matgaldino/Autonomous-Taxi/mechanical/encoder_mount/encoder_mount_front_view.png

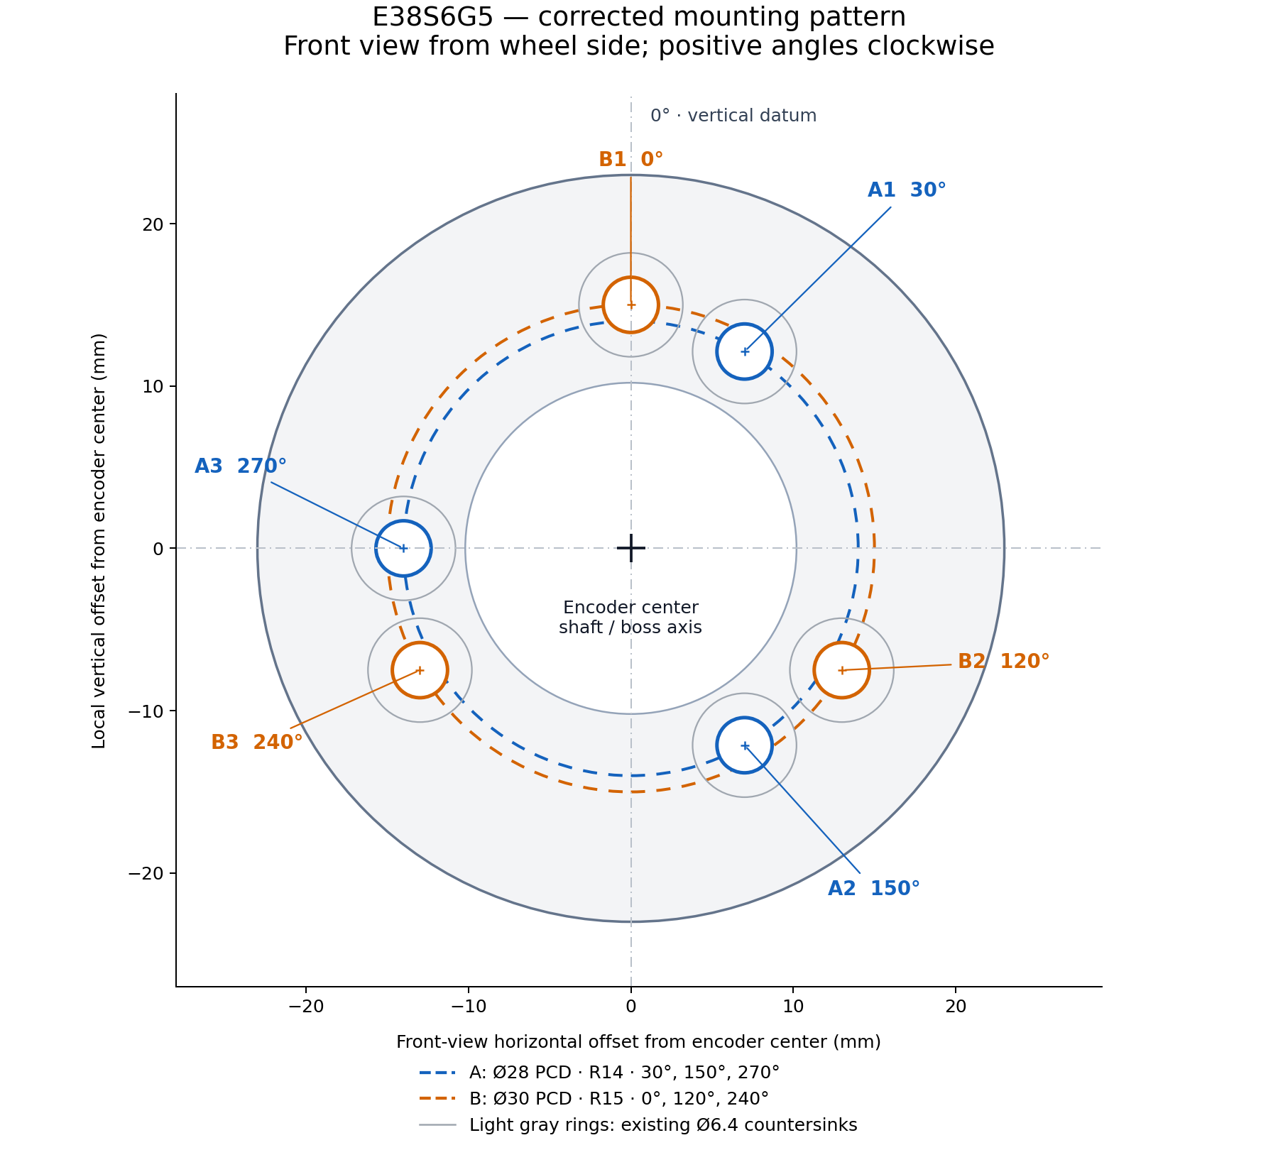
mechanical/encoder_mount/encoder_mount_front_view.png
