matgaldino/Autonomous-Taxi/mechanical/encoder_mount/vehicle_layout_front.png

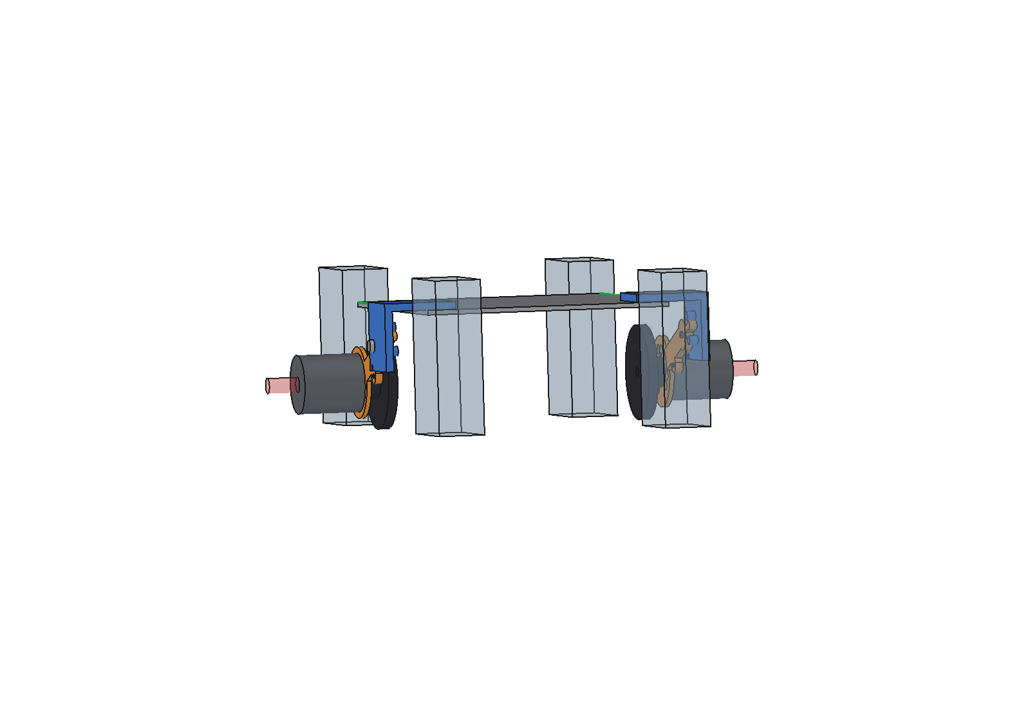
mechanical/encoder_mount/vehicle_layout_front.png
