matgaldino/Autonomous-Taxi/mechanical/encoder_mount/vehicle_layout_isometric.png

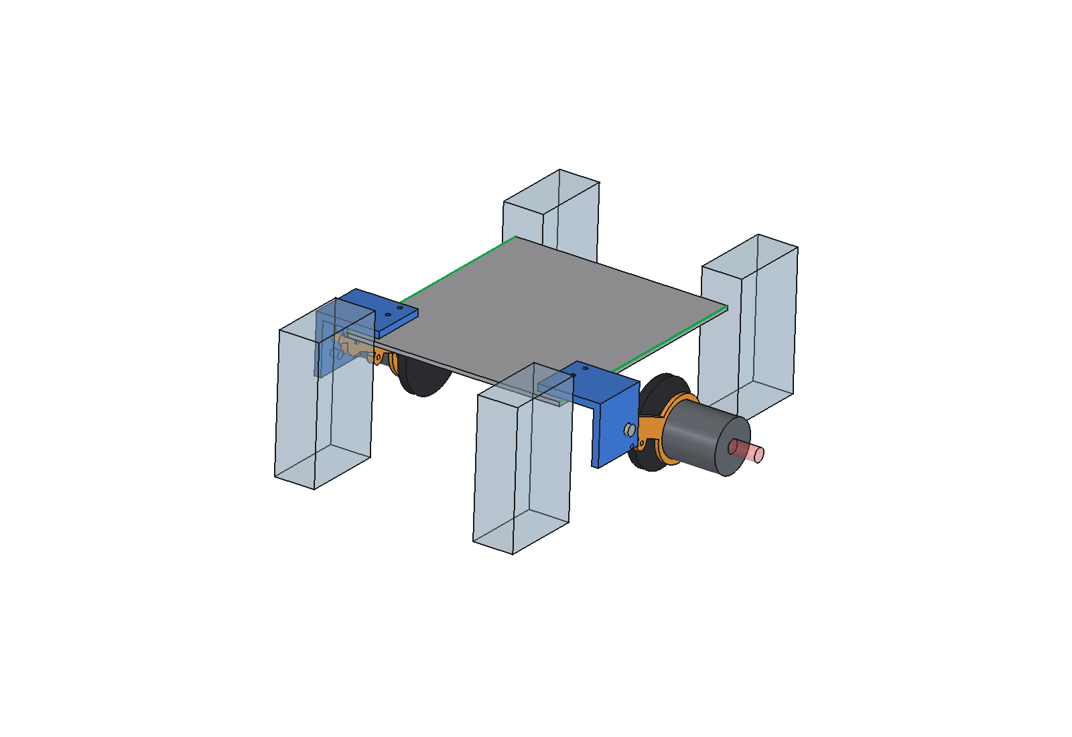
mechanical/encoder_mount/vehicle_layout_isometric.png
