matgaldino/Autonomous-Taxi/mechanical/encoder_mount/vehicle_layout_side.png

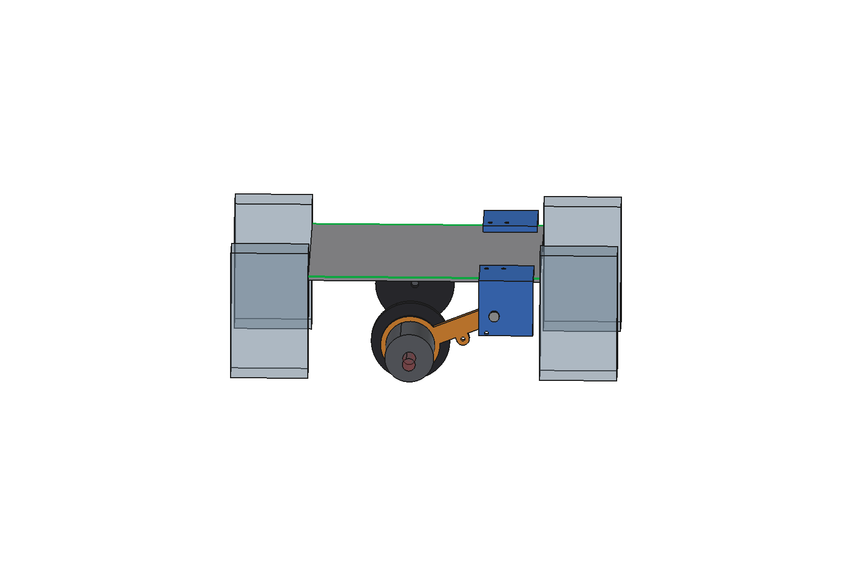
mechanical/encoder_mount/vehicle_layout_side.png
