matgaldino/Autonomous-Taxi/mechanical/encoder_mount/vehicle_layout_top.png

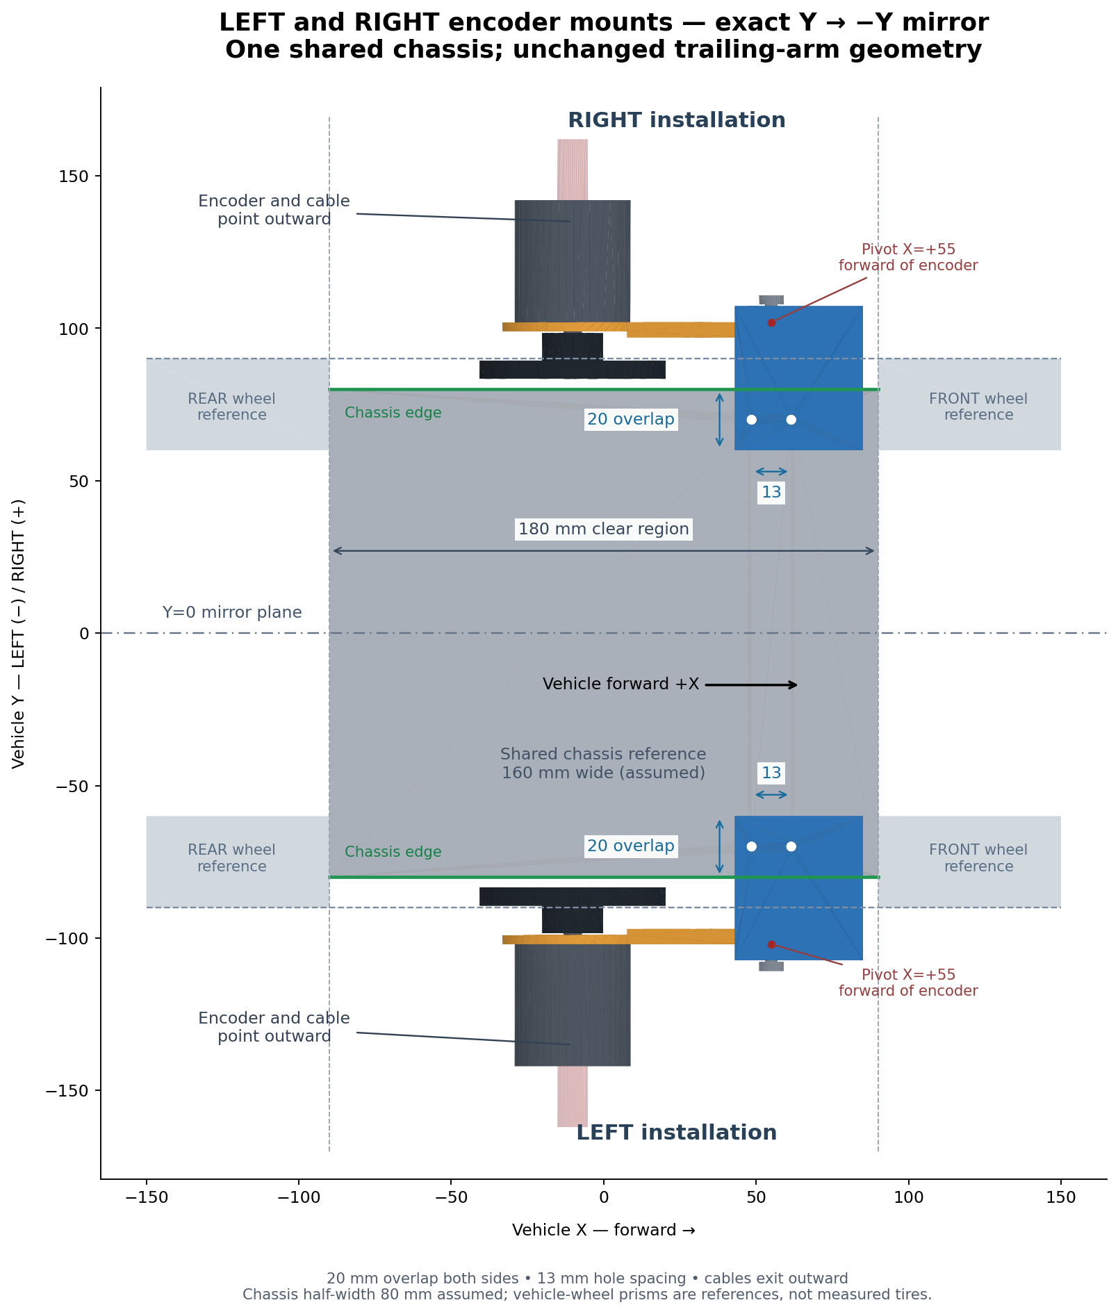
mechanical/encoder_mount/vehicle_layout_top.png
