matgaldino/Autonomous-Taxi/mechanical/encoder_mount/encoder_mount.FCStd

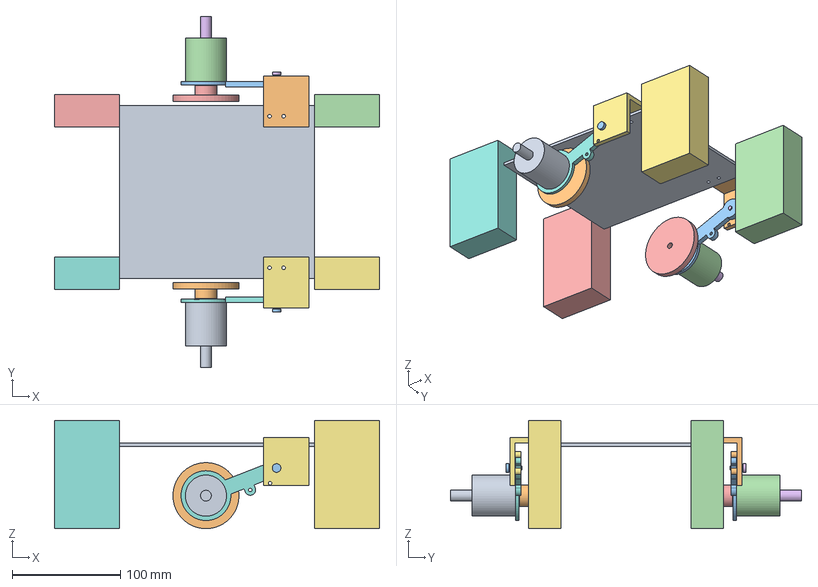
[picture p6: CAD file, 2026-11-02]
mechanical/encoder_mount/encoder_mount.FCStd
300.0 x 324.0 x 100.0 mm
ChassisReference
ChassisBracketRight
ArticulatedArmRight
EncoderRight
OdometryWheelRight
PivotPlaceholderRight
ChassisBracketLeft
ArticulatedArmLeft
EncoderLeft
OdometryWheelLeft
PivotPlaceholderLeft
FrontVehicleWheelReferenceRight
RearVehicleWheelReferenceRight
CableClearanceReferenceRight
FrontVehicleWheelReferenceLeft
RearVehicleWheelReferenceLeft
CableClearanceReferenceLeft
