matgaldino/Autonomous-Taxi/mechanical/encoder_mount/stl/articulated_arm_right.stl

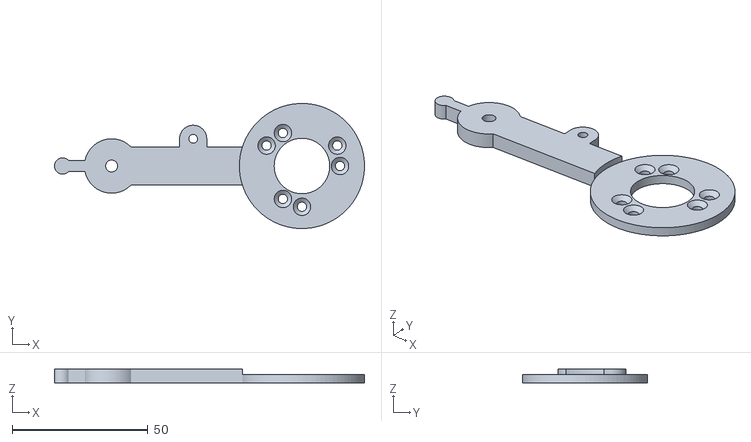
[picture p7: CAD file, 2026-11-02]
mechanical/encoder_mount/stl/articulated_arm_right.stl
114.0 x 46.0 x 5.00
