matgaldino/Autonomous-Taxi/mechanical/encoder_mount/stl/chassis_bracket_right.stl

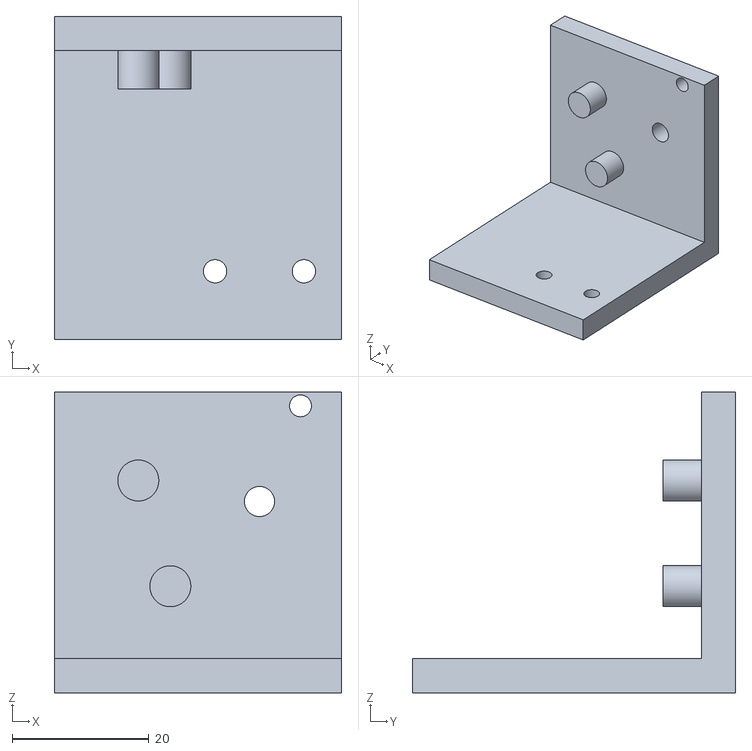
[picture p8: CAD file, 2026-11-02]
mechanical/encoder_mount/stl/chassis_bracket_right.stl
42.0 x 47.3 x 44.0
