matgaldino/Autonomous-Taxi/(list of files, cad)

Other CAD files:
mechanical/encoder_mount/stl/articulated_arm_left.stl
mechanical/encoder_mount/stl/chassis_bracket_left.stl
