matgaldino/Autonomous-Taxi/firmware/stm32_vehicle_controller/Core/Src/main.c

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
/* Includes ------------------------------------------------------------------*/
#include "main.h"

/* USER CODE BEGIN Includes */
#include <stdio.h>
#include <string.h>
/* USER CODE END Includes */

/* USER CODE BEGIN PM */
#define STEERING_NEG_US          1100
#define STEERING_CENTER_US       1400
#define STEERING_POS_US          1700

#define ESC_FULL_REVERSE_US      1100
#define ESC_REVERSE_START_US     1200
#define ESC_NEUTRAL_US           1500
#define ESC_FORWARD_START_US     1600
#define ESC_FULL_FORWARD_US      1900

#define COMMAND_MAX              1000
#define UART_BUFFER_SIZE         64
#define SERIAL_WATCHDOG_MS       500
/* USER CODE END PM */

TIM_HandleTypeDef htim1;

UART_HandleTypeDef huart2;

/* USER CODE BEGIN PV */
uint8_t rx_byte;

char rx_buffer[UART_BUFFER_SIZE];
uint8_t rx_index = 0;

uint32_t last_command_ms = 0;
uint8_t watchdog_active = 0;

int16_t steering_cmd = 0;
int16_t throttle_cmd = 0;

uint16_t steering_pwm = STEERING_CENTER_US;
uint16_t esc_pwm = ESC_NEUTRAL_US;

int8_t drive_direction = 0;
// -1 = reverse
//  0 = neutral
// +1 = forward
/* USER CODE END PV */

void SystemClock_Config(void);
static void MX_GPIO_Init(void);
static void MX_TIM1_Init(void);
static void MX_USART2_UART_Init(void);
/* USER CODE BEGIN 0 */
static int16_t clamp_command(int value)
{
    if (value > COMMAND_MAX)
        return COMMAND_MAX;

    if (value < -COMMAND_MAX)
        return -COMMAND_MAX;

    return (int16_t)value;
}


static uint16_t steering_to_pwm(int16_t command)
{
    if (command > 0)
    {
        return STEERING_CENTER_US -
            ((uint32_t)command *
            (STEERING_CENTER_US - STEERING_NEG_US)) /
            COMMAND_MAX;
    }

    if (command < 0)
    {
        return STEERING_CENTER_US +
            ((uint32_t)(-command) *
            (STEERING_POS_US - STEERING_CENTER_US)) /
            COMMAND_MAX;
    }

    return STEERING_CENTER_US;
}


static uint16_t throttle_to_pwm(int16_t command)
{
    if (command > 0)
    {
        return ESC_FORWARD_START_US +
            ((uint32_t)command *
            (ESC_FULL_FORWARD_US - ESC_FORWARD_START_US)) /
            COMMAND_MAX;
    }

    if (command < 0)
    {
        return ESC_REVERSE_START_US -
            ((uint32_t)(-command) *
            (ESC_REVERSE_START_US - ESC_FULL_REVERSE_US)) /
            COMMAND_MAX;
    }

    return ESC_NEUTRAL_US;
}


static void apply_vehicle_command(int16_t steering, int16_t throttle)
{
    steering = clamp_command(steering);
    throttle = clamp_command(throttle);

    steering_cmd = steering;
    throttle_cmd = throttle;

    steering_pwm = steering_to_pwm(steering);

    __HAL_TIM_SET_COMPARE(
        &htim1,
        TIM_CHANNEL_1,
        steering_pwm
    );

    int8_t requested_direction = 0;

    if (throttle > 0)
        requested_direction = 1;
    else if (throttle < 0)
        requested_direction = -1;

    /*
     * Direct direction change:
     *
     * forward -> reverse
     * reverse -> forward
     *
     * Force an explicit neutral cycle first.
     */
    if (
        drive_direction != 0 &&
        requested_direction != 0 &&
        requested_direction != drive_direction
    )
    {
        esc_pwm = ESC_NEUTRAL_US;
        drive_direction = 0;

        __HAL_TIM_SET_COMPARE(
            &htim1,
            TIM_CHANNEL_4,
            esc_pwm
        );

        return;
    }

    esc_pwm = throttle_to_pwm(throttle);

    __HAL_TIM_SET_COMPARE(
        &htim1,
        TIM_CHANNEL_4,
        esc_pwm
    );

    drive_direction = requested_direction;
}


static void send_status(void)
{
    char buffer[128];

    snprintf(
        buffer,
        sizeof(buffer),
        "OK S=%d T=%d SPWM=%u EPWM=%u\r\n",
        steering_cmd,
        throttle_cmd,
        steering_pwm,
        esc_pwm
    );

    HAL_UART_Transmit(
        &huart2,
        (uint8_t *)buffer,
        strlen(buffer),
        HAL_MAX_DELAY
    );
}


static void process_command(char *line)
{
    int steering;
    int throttle;

    if (sscanf(line, "C,%d,%d", &steering, &throttle) == 2)
    {
        apply_vehicle_command(
            (int16_t)steering,
            (int16_t)throttle
        );

        last_command_ms = HAL_GetTick();
        watchdog_active = 0;

        send_status();
    }
}
/* USER CODE END 0 */

/**
  * @brief  The application entry point.
  * @retval int
  */
int main(void)
{

  /* MCU Configuration--------------------------------------------------------*/

  /* Reset of all peripherals, Initializes the Flash interface and the Systick. */
  HAL_Init();

  /* Configure the system clock */
  SystemClock_Config();

  /* Initialize all configured peripherals */
  MX_GPIO_Init();
  MX_TIM1_Init();
  MX_USART2_UART_Init();
  /* USER CODE BEGIN 2 */
  HAL_TIM_PWM_Start(&htim1, TIM_CHANNEL_1);
  HAL_TIM_PWM_Start(&htim1, TIM_CHANNEL_4);

  apply_vehicle_command(0, 0);

  last_command_ms = HAL_GetTick();
  /* USER CODE END 2 */

  /* Initialize leds */
  BSP_LED_Init(LED_GREEN);

  /* Infinite loop */
  /* USER CODE BEGIN WHILE */
  while (1)
  {
	  if (HAL_UART_Receive(&huart2, &rx_byte, 1, 1) == HAL_OK)
	      {
	          if (rx_byte == '\n' || rx_byte == '\r')
	          {
	              if (rx_index > 0)
	              {
	                  rx_buffer[rx_index] = '\0';

	                  process_command(rx_buffer);

	                  rx_index = 0;
	              }
	          }
	          else
	          {
	              if (rx_index < UART_BUFFER_SIZE - 1)
	              {
	                  rx_buffer[rx_index++] = rx_byte;
	              }
	              else
	              {
	                  rx_index = 0;
	              }
	          }
	      }

	      if (
	          !watchdog_active &&
	          (HAL_GetTick() - last_command_ms > SERIAL_WATCHDOG_MS)
	      )
	      {
	          apply_vehicle_command(0, 0);

	          watchdog_active = 1;
	      }
    /* USER CODE END WHILE */

    /* USER CODE BEGIN 3 */
  }
  /* USER CODE END 3 */
}

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
