matgaldino/Autonomous-Taxi/firmware/stm32_vehicle_controller/stm32_vehicle_controller.ioc

Mcu.UserName=STM32L432KCUx
PA0.GPIO_Label=MCO [High speed clock in]
PA0.Signal=RCC_CK_IN
PA11.Signal=S_TIM1_CH4
PA2.GPIO_Label=VCP_TX
PA2.Signal=USART2_TX
PA8.Signal=S_TIM1_CH1
