matgaldino/Autonomous-Taxi/(commit log)

2026-09-22 Add STM32 steering and ESC PWM control
2026-09-22 Add STM32 serial vehicle control protocol
2026-09-22 Invert steering control logic
    [main.c]
2026-09-22 Add ROS serial bridge for STM32 vehicle control
2026-09-22 Document STM32 vehicle control integration
2026-09-24 Ignore STM32CubeIDE local preferences
2026-11-02 Add articulated encoder wheel mount
